FarhanNITT/Autonomous-Railway-Inspection-Bot/Design Files/Hardware Design Files/STEP/Aribot Assembly File - Hardware Mark 1.STEP

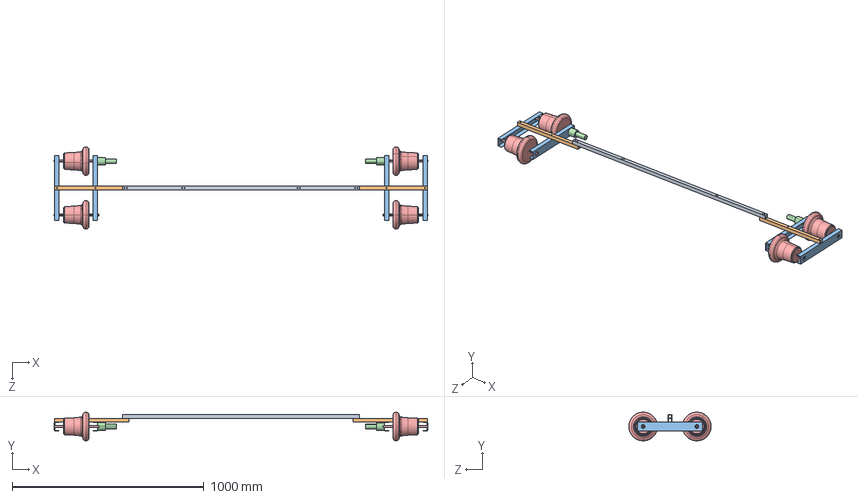
[picture p22: CAD file, 2024-10-16]
Design Files/Hardware Design Files/STEP/Aribot Assembly File - Hardware Mark 1.STEP
1953.0 x 150.0 x 430.0 mm
Main Rod
Auxiliary Rod x 2
Side Unit Main Structural Member x 4
Motor Cylinder x 2
Wheel x 4
