FarhanNITT/Autonomous-Railway-Inspection-Bot/Design Files/Hardware Design Files/STL/Aribot Assembly File - Hardware Mark 1 - Side Unit Main Structural Member-3.STL

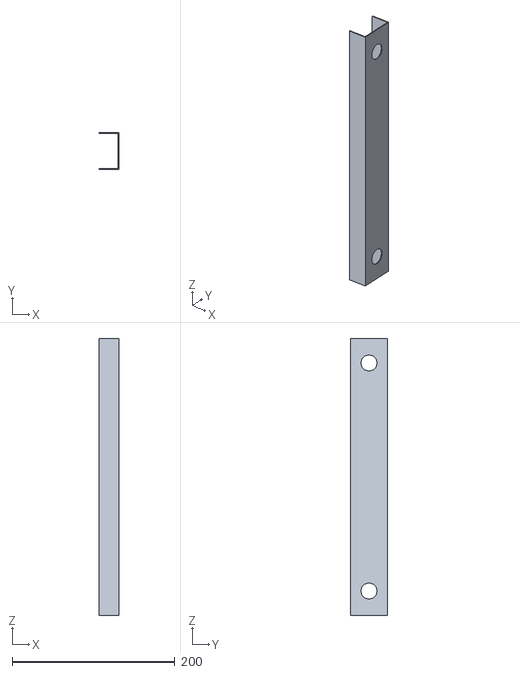
[picture p23: CAD file, 2024-10-16]
Design Files/Hardware Design Files/STL/Aribot Assembly File - Hardware Mark 1 - Side Unit Main Structural Member-3.STL
24.0 x 45.0 x 340.0
