FarhanNITT/Autonomous-Railway-Inspection-Bot/Design Files/Hardware Design Files/Main Rod.SLDPRT

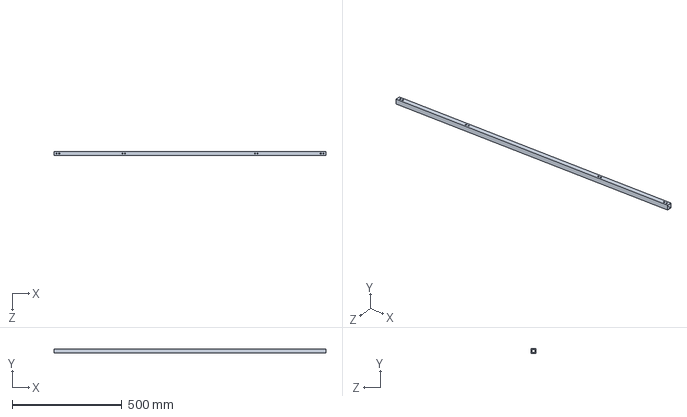
[picture p24: CAD file, 2024-10-16]
Design Files/Hardware Design Files/Main Rod.SLDPRT
1240.0 x 20.0 x 20.0 mm
