FarhanNITT/Autonomous-Railway-Inspection-Bot/Design Files/Hardware Design Files/STL/Aribot Assembly File - Hardware Mark 1 - Wheel-4.STL

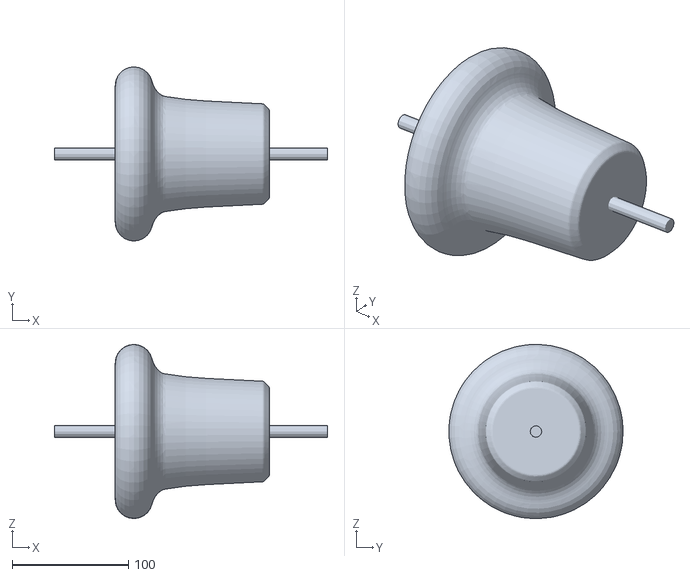
[picture p25: CAD file, 2024-10-16]
Design Files/Hardware Design Files/STL/Aribot Assembly File - Hardware Mark 1 - Wheel-4.STL
235.0 x 150.0 x 149.9
