FarhanNITT/Autonomous-Railway-Inspection-Bot/ARIBOT-ROS/meshes/Main_Frame.STL

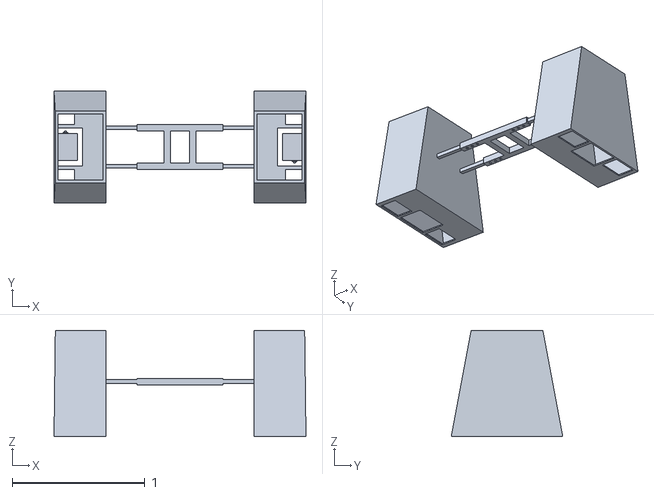
[picture p26: CAD file, 2024-10-16]
ARIBOT-ROS/meshes/Main_Frame.STL
1.90 x 0.841 x 0.802
