FarhanNITT/Autonomous-Railway-Inspection-Bot/Design Files/Hardware Design Files/STL/Aribot Assembly File - Hardware Mark 1 - Motor Cylinder-2.STL

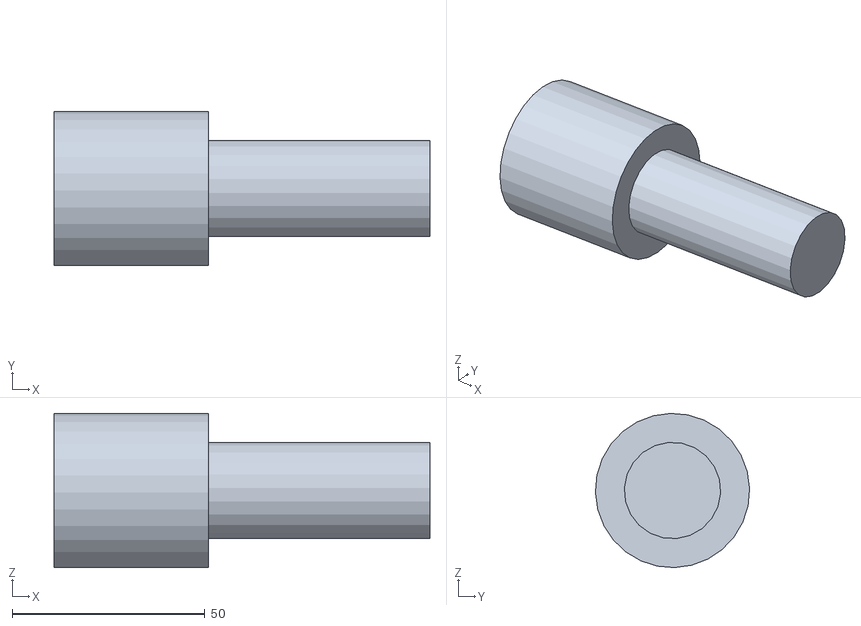
[picture p27: CAD file, 2024-10-16]
Design Files/Hardware Design Files/STL/Aribot Assembly File - Hardware Mark 1 - Motor Cylinder-2.STL
97.5 x 40.0 x 40.0
