FarhanNITT/Autonomous-Railway-Inspection-Bot/Design Files/Hardware Design Files/STL/Aribot Assembly File - Hardware Mark 1 - Wheel-1.STL

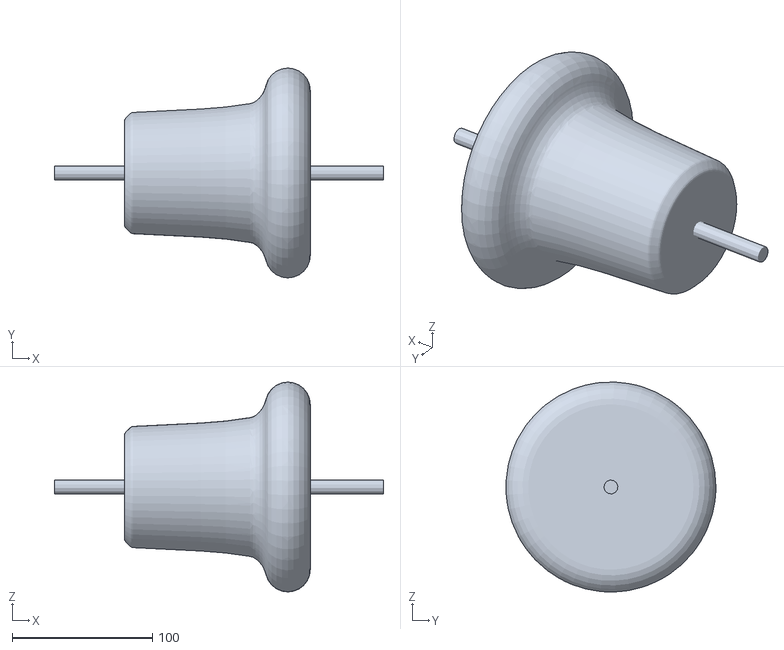
[picture p28: CAD file, 2024-10-16]
Design Files/Hardware Design Files/STL/Aribot Assembly File - Hardware Mark 1 - Wheel-1.STL
235.0 x 149.9 x 149.9
