FarhanNITT/Autonomous-Railway-Inspection-Bot/Design Files/full chassis assembly.SLDASM

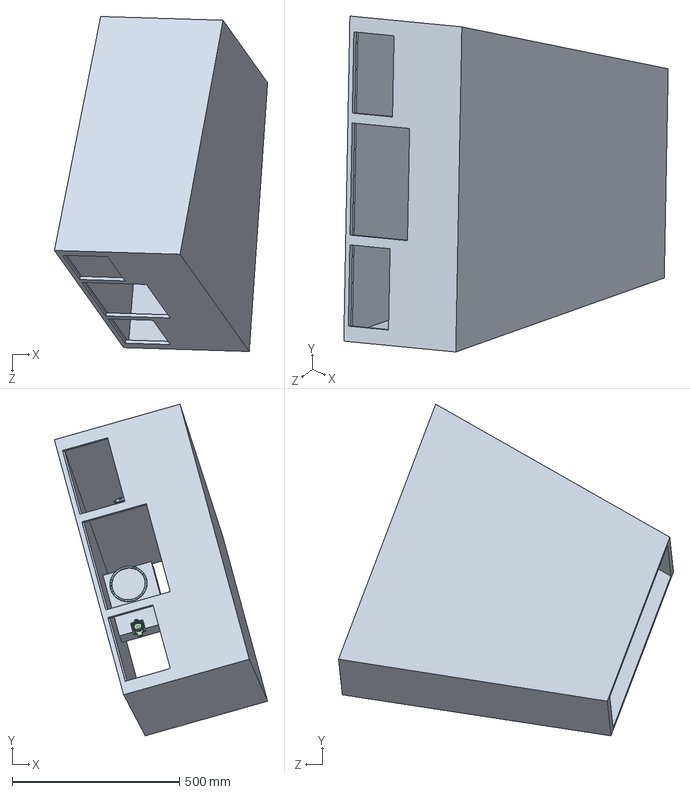
[picture p29: CAD file, 2024-10-16]
Design Files/full chassis assembly.SLDASM
636.6 x 990.2 x 1000.2 mm
chassis
DC Motor x 2
TFmini-S Micro Lidar x 2
Raspberry Pi HQ Camera..STEP
fillister head screw_ai_CR-FIMS 0.086-64x0.188x0.188-N.STEP x 2
fillister head screw_ai_CR-FIMS 0.06-80x0.3125x0.3125-N.STEP
Camera Connector from RPi4ModelB.STEP
Neopixel Ring 35 5volt v1.step
