FarhanNITT/Autonomous-Railway-Inspection-Bot/Design Files/Hardware Design Files/STL/Aribot Assembly File - Hardware Mark 1 - Motor Cylinder-3.STL

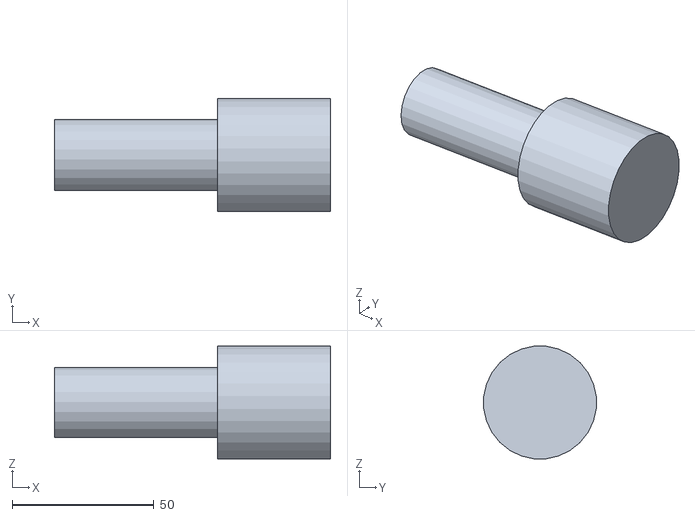
[picture p30: CAD file, 2024-10-16]
Design Files/Hardware Design Files/STL/Aribot Assembly File - Hardware Mark 1 - Motor Cylinder-3.STL
97.5 x 39.8 x 39.8
