FarhanNITT/Autonomous-Railway-Inspection-Bot/Design Files/Central Main Frame.SLDPRT

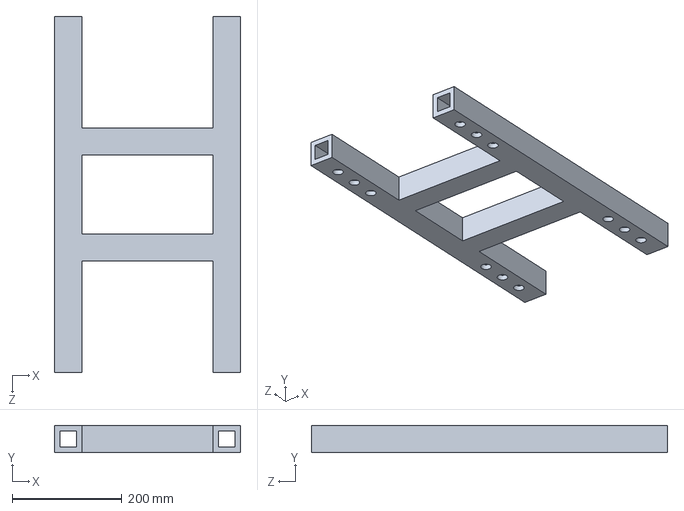
[picture p31: CAD file, 2024-10-16]
Design Files/Central Main Frame.SLDPRT
340.0 x 50.0 x 650.0 mm
