FarhanNITT/Autonomous-Railway-Inspection-Bot/ARIBOT-ROS/meshes/BLW.STL

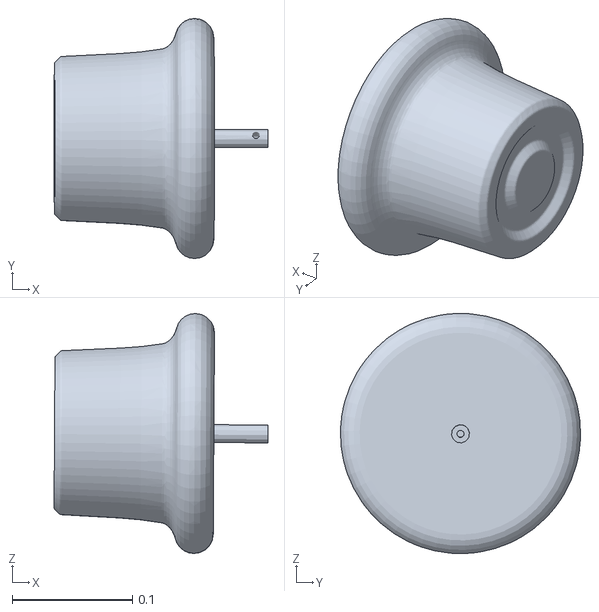
[picture p33: CAD file, 2024-10-16]
ARIBOT-ROS/meshes/BLW.STL
0.178 x 0.2 x 0.2
