FarhanNITT/Autonomous-Railway-Inspection-Bot/Design Files/chassis.SLDPRT

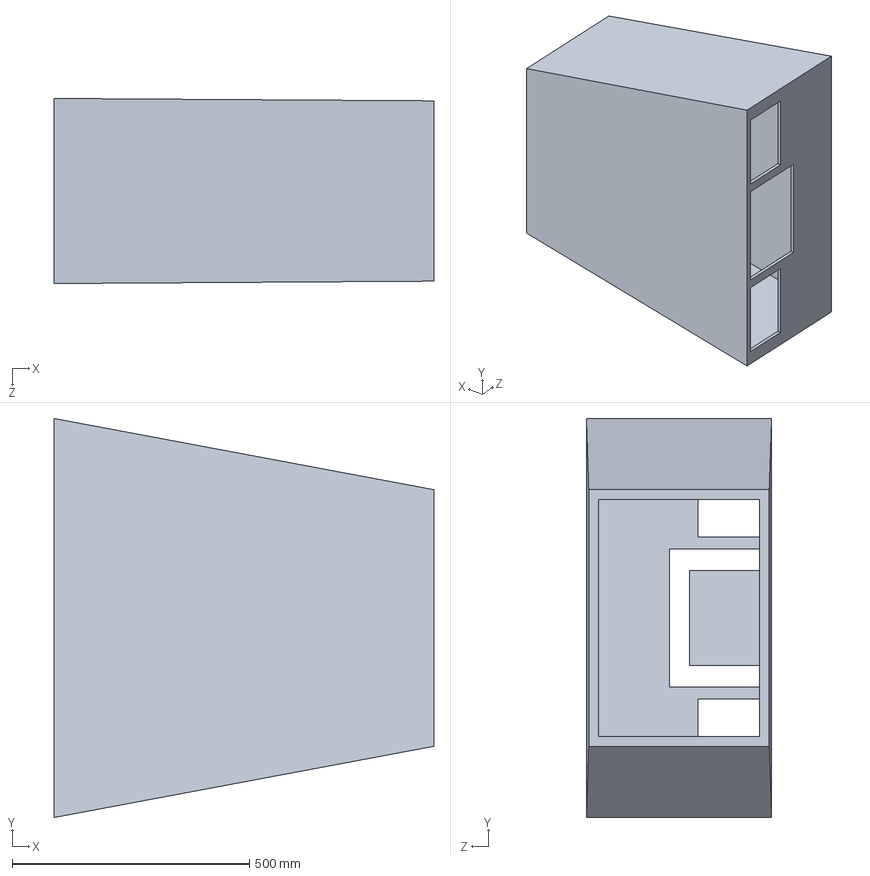
[picture p34: CAD file, 2024-10-16]
Design Files/chassis.SLDPRT
800.0 x 840.7 x 390.0 mm
