FarhanNITT/Autonomous-Railway-Inspection-Bot/Design Files/Motor Wheel Coupler.SLDPRT

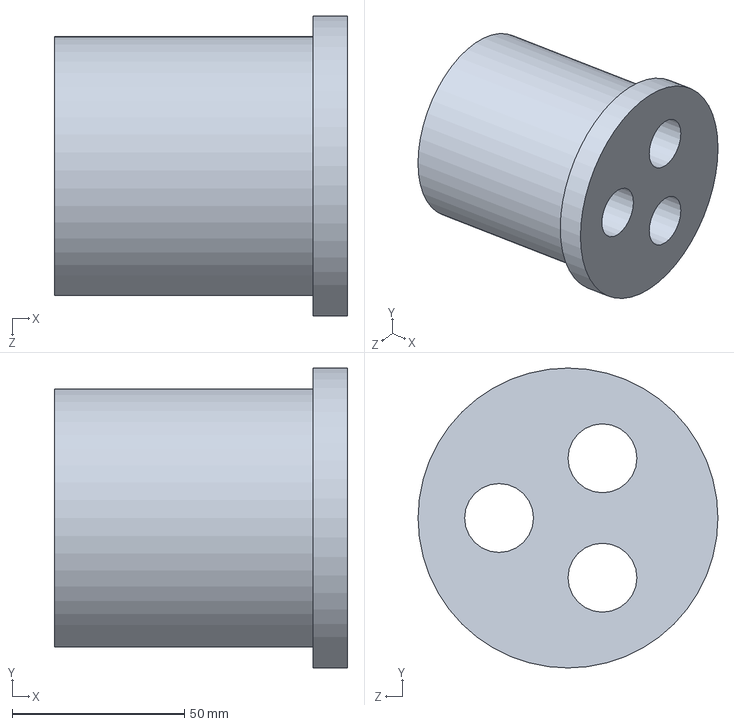
[picture p35: CAD file, 2024-10-16]
Design Files/Motor Wheel Coupler.SLDPRT
85.0 x 87.0 x 87.0 mm
