FarhanNITT/Autonomous-Railway-Inspection-Bot/Design Files/inner rods.SLDPRT

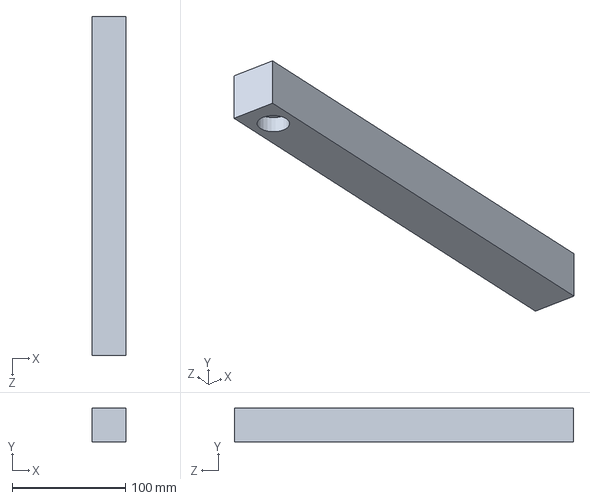
[picture p36: CAD file, 2024-10-16]
Design Files/inner rods.SLDPRT
30.0 x 30.0 x 300.0 mm
