FarhanNITT/Autonomous-Railway-Inspection-Bot/Design Files/Rail Track.SLDPRT

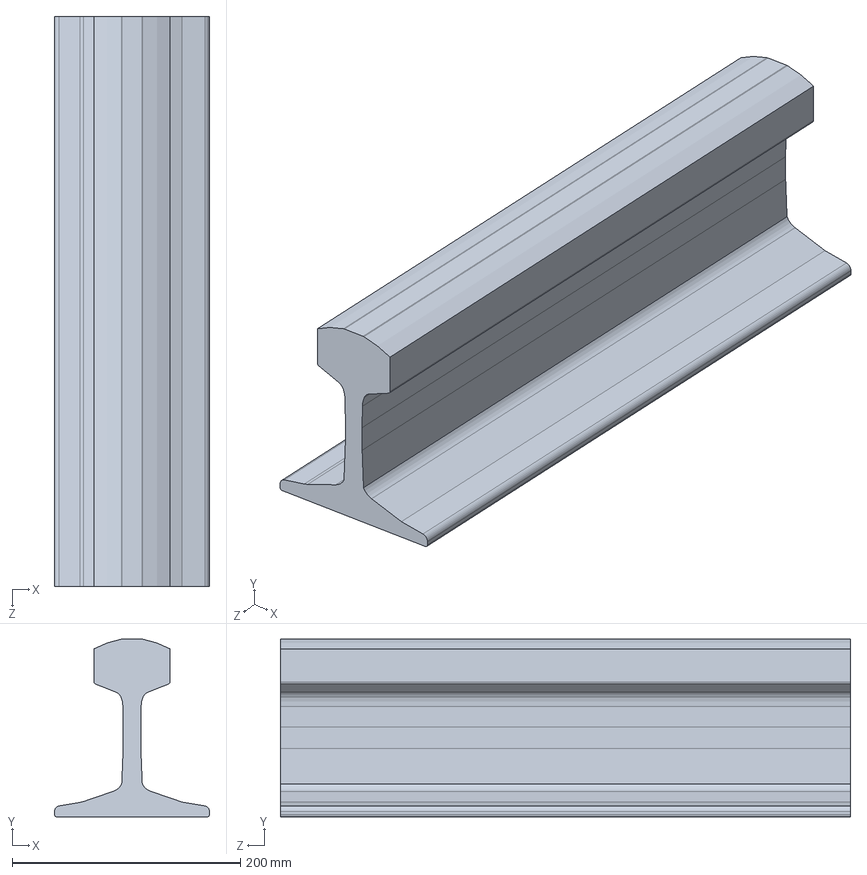
[picture p37: CAD file, 2024-10-16]
Design Files/Rail Track.SLDPRT
136.0 x 156.0 x 500.0 mm
