FarhanNITT/Autonomous-Railway-Inspection-Bot/Design Files/Hardware Design Files/Wheel.SLDPRT

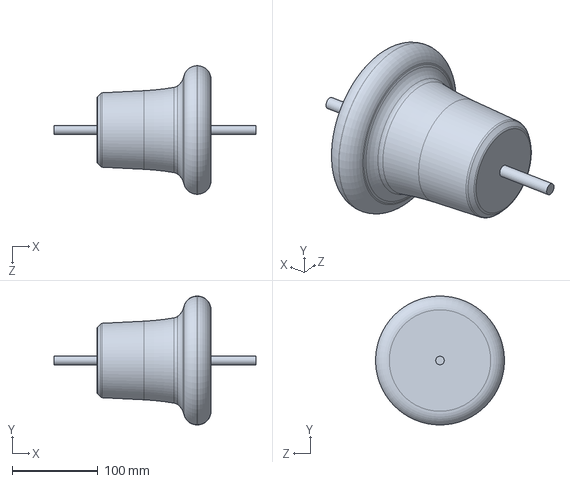
[picture p38: CAD file, 2024-10-16]
Design Files/Hardware Design Files/Wheel.SLDPRT
235.0 x 150.0 x 149.8 mm
