FarhanNITT/Autonomous-Railway-Inspection-Bot/Design Files/Aribot Wheel (15 cm Diameter).SLDPRT

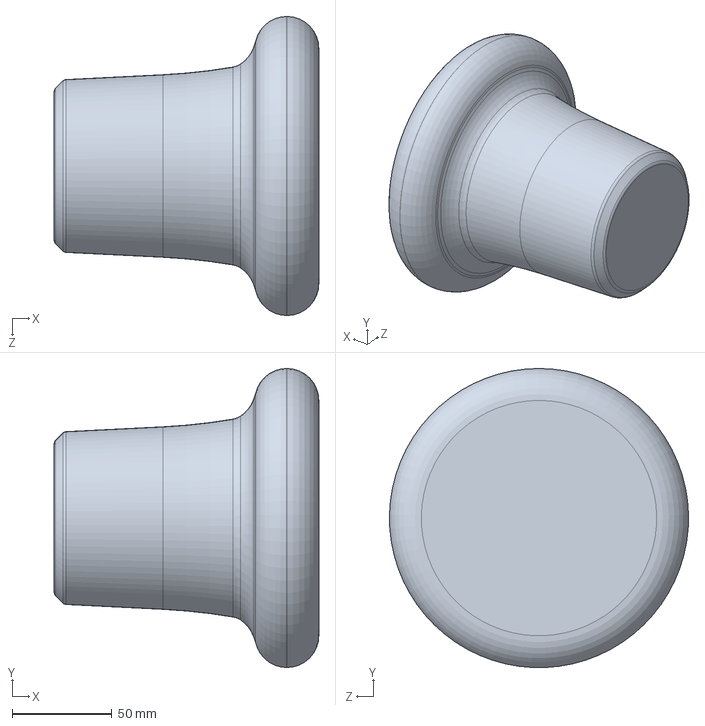
[picture p39: CAD file, 2024-10-16]
Design Files/Aribot Wheel (15 cm Diameter).SLDPRT
132.7 x 149.9 x 150.0 mm
