FarhanNITT/Autonomous-Railway-Inspection-Bot/(list of files, cad)

Other CAD files:
Design Files/Hardware Design Files/STL/Aribot Assembly File - Hardware Mark 1 - Wheel-3.STL
Design Files/Hardware Design Files/Side Unit Main Structural Member.SLDPRT
Design Files/Hardware Design Files/STL/Aribot Assembly File - Hardware Mark 1 - Main Rod-1.STL
Design Files/Hardware Design Files/STL/Aribot Assembly File - Hardware Mark 1 - Side Unit Main Structural Member-4.STL
Design Files/Hardware Design Files/STL/Aribot Assembly File - Hardware Mark 1 - Side Unit Main Structural Member-2.STL
Design Files/Hardware Design Files/STL/Aribot Assembly File - Hardware Mark 1 - Auxiliary Rod-2.STL
Design Files/Hardware Design Files/STL/Aribot Assembly File - Hardware Mark 1 - Side Unit Main Structural Member-1.STL
Design Files/Hardware Design Files/STL/Aribot Assembly File - Hardware Mark 1 - Wheel-2.STL
Design Files/Hardware Design Files/Motor Cylinder.SLDPRT
ARIBOT-ROS/meshes/FRW.STL
Design Files/Hardware Design Files/Auxiliary Rod.SLDPRT
ARIBOT-ROS/meshes/BRW.STL
ARIBOT-ROS/meshes/FLW.STL
Design Files/rods.SLDPRT
Design Files/Hardware Design Files/STL/aribot.STL
Design Files/Hardware Design Files/Aribot Assembly File - Hardware Mark 1.SLDASM
